CarloFalco/WeatherStation/docs/WeatherStationV2.pdf

### GND

+3V3

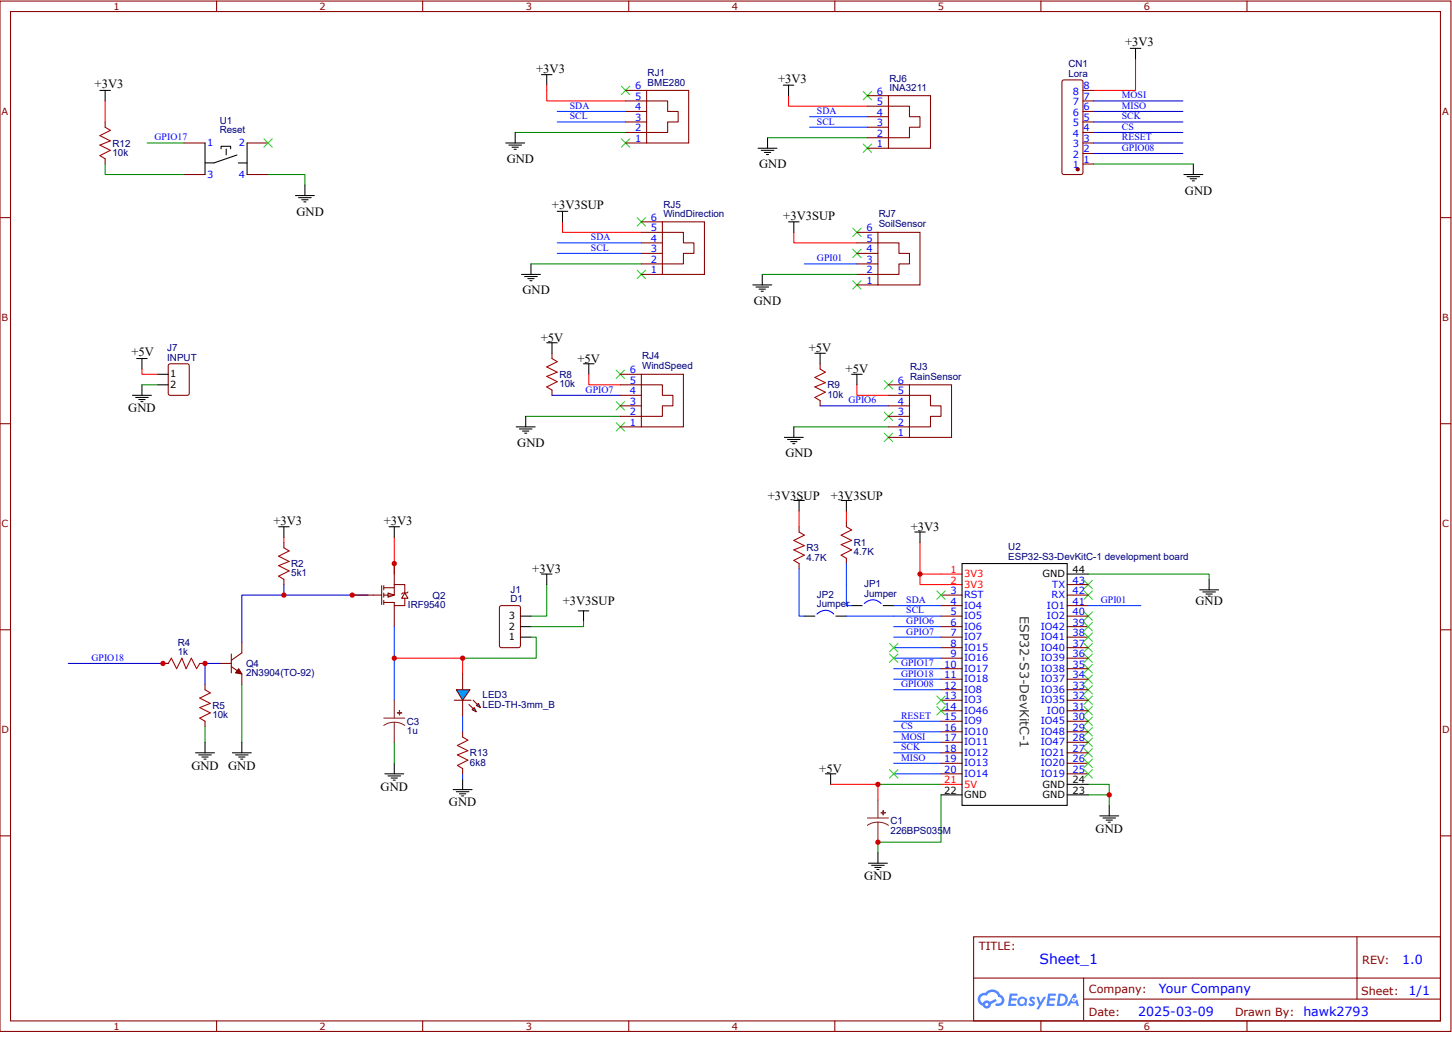
[picture p1: page 1]
