CarloFalco/WeatherStation/docs/WeatherStationV2_PCB.pdf

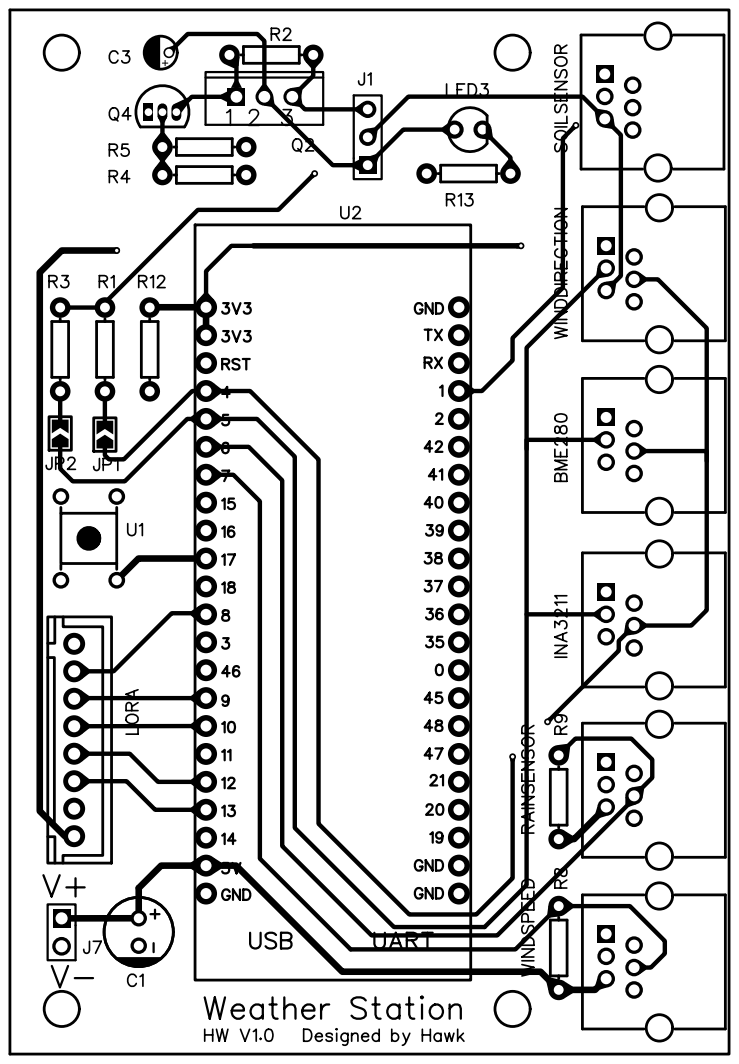
[picture p2: page 1]
