CarloFalco/WeatherStation/include/config.h

/**
 * @file config.h
 * @brief Hardware configuration: GPIO pinout, I2C addresses, board constants.
 *
 * Single source of truth for the wiring of the station. Runtime-tunable
 * parameters (wake interval, station ID, LoRa settings, ...) do NOT belong
 * here: they live in /config.ini on LittleFS (see AppConfig, Increment 1).
 */

#ifndef WEATHERSTATION_CONFIG_H
#define WEATHERSTATION_CONFIG_H

#include <Arduino.h>

// ---------------------------------------------------------------------------
// LoRa SX1276 868 MHz (SPI)
// ---------------------------------------------------------------------------
#define LORA_SCK   GPIO_NUM_12  ///< SPI clock
#define LORA_MISO  GPIO_NUM_13  ///< SPI MISO
#define LORA_MOSI  GPIO_NUM_11  ///< SPI MOSI
#define LORA_CS    GPIO_NUM_10  ///< SPI chip select (NSS)
#define LORA_RST   GPIO_NUM_9   ///< Radio reset
#define LORA_DIO0  GPIO_NUM_8   ///< TX/RX done interrupt

// ---------------------------------------------------------------------------
// I2C bus (BME280, AS5600, INA3221)
// The ESP32-S3 Arduino defaults (SDA=8, SCL=9) clash with LORA_DIO0/LORA_RST,
// so the bus is remapped to GPIO 4/5.
// ---------------------------------------------------------------------------
#define I2C_SDA    GPIO_NUM_4   ///< I2C data
#define I2C_SCL    GPIO_NUM_5   ///< I2C clock

/// BME280 temperature/humidity/pressure sensor I2C address.
/// (Named *_I2C_ADDR because the Adafruit driver already defines
/// BME280_ADDRESS as its 0x77 default.)
#define BME280_I2C_ADDR 0x76
/// AS5600 magnetic encoder (wind direction) I2C address.
#define AS5600_ADDRESS 0x36
/// INA3221 3-channel current monitor (panel/battery/load) I2C address.
#define INA3221_ADDRESS 0x40

// ---------------------------------------------------------------------------
// Pulse sensors (reed switches)
// ---------------------------------------------------------------------------
#define RAIN_GAUGE_PIN GPIO_NUM_6  ///< Tipping-bucket rain gauge (RTC-capable, used for wake-on-rain)
#define ANEMOMETER_PIN GPIO_NUM_7  ///< Cup anemometer reed switch

// ---------------------------------------------------------------------------
// Analog sensors
// ---------------------------------------------------------------------------
/// Capacitive soil moisture probe (analog output).
/// GPIO 1 = ADC1_CH0: ADC1 is mandatory here, ADC2 is unusable while WiFi is
/// on and is reserved on this board anyway.
/// WARNING: the probe must be powered at 3.3 V. Powered at 5 V its output
/// swings up to ~4.2 V and would exceed the ESP32-S3 ADC input rating.
#define SOIL_MOISTURE_PIN GPIO_NUM_1

// ---------------------------------------------------------------------------
// User interface / power control
// ---------------------------------------------------------------------------
/// Factory-reset push button to GND (RTC-capable: also a deep-sleep wake source).
#define FACTORY_RESET_PIN GPIO_NUM_17

/// Sensor rail load-switch control (RTC-capable, state held during deep sleep).
/// Currently only driven to a defined ON level at boot: which devices sit on
/// the switched rail is still an open hardware decision (see
/// docs/power-budget.md), and cutting the rail is only worth it for the
/// AS5600 and the soil probe.
#define SENSOR_POWER_PIN GPIO_NUM_18
/// Logic level that turns the sensor rail ON (depends on the switch topology:
/// direct P-MOSFET gate = LOW, N-MOSFET/inverted driver or boost EN = HIGH).
#define SENSOR_POWER_ON_LEVEL HIGH

// ---------------------------------------------------------------------------
// Misc
// ---------------------------------------------------------------------------
#define STATUS_LED_PIN LED_BUILTIN  ///< On-board status LED (validated on hardware)

/// CPU frequency during the wake window [MHz]. 80 MHz roughly halves the
/// active current vs the default 240 MHz; nothing in the cycle (I2C, SPI,
/// UART, LoRa) needs more.
#define CPU_FREQ_MHZ 80

#endif // WEATHERSTATION_CONFIG_H
