CarloFalco/WeatherStation/include/rtc_state.h

/**
 * @file rtc_state.h
 * @brief State preserved in RTC slow memory across deep-sleep cycles.
 *
 * Variables placed in RTC RAM survive deep sleep but are reset to their
 * initializers on a power-on reset (cold boot). Everything the station
 * must remember between wake-ups without touching flash lives here:
 * flash writes are slow, power-hungry and wear the chip out, RTC RAM
 * is free.
 */

#ifndef WEATHERSTATION_RTC_STATE_H
#define WEATHERSTATION_RTC_STATE_H

#include <Arduino.h>

/**
 * @brief OTA transfer progress, preserved across deep sleep.
 *
 * A full firmware image takes ~20 minutes over LoRa: without this, any
 * interruption would restart the transfer from chunk 0. The station
 * resumes from @ref nextChunk as soon as the base offers the same image
 * again (matching size/crc/chunks).
 */
struct RtcOtaState {
    uint32_t size;        ///< Expected image size [bytes]; 0 = no transfer pending.
    uint32_t crc;         ///< Expected CRC-32 of the whole image.
    uint16_t chunks;      ///< Total number of chunks of the image.
    uint16_t nextChunk;   ///< First chunk still to receive (resume point).
    uint32_t runningCrc;  ///< CRC-32 accumulator over the chunks already stored.
};

/**
 * @brief Persistent station state, kept in RTC RAM between deep sleeps.
 */
struct RtcState {
    uint32_t bootCount;      ///< Wake-up cycles since power-on (1 = cold boot).
    uint16_t msgSeq;         ///< LoRa telemetry sequence counter ("seq" JSON field).
    uint32_t rainPulses;     ///< Tipping-bucket pulses accumulated since the last
                             ///< acknowledged transmission.
    uint64_t nextWakeEpochS; ///< Scheduled time of the next measurement cycle
                             ///< [s, RTC epoch]. The RTC clock keeps running in
                             ///< deep sleep, so after a rain wake-up the station
                             ///< can go back to sleep for the remaining time
                             ///< instead of restarting the full interval.
    RtcOtaState ota;         ///< OTA transfer progress (resume across cycles).
};

/// Global RTC-resident state instance (defined in PowerManager.cpp).
extern RtcState g_rtcState;

#endif // WEATHERSTATION_RTC_STATE_H
