CarloFalco/WeatherStation/src/core/AppConfig.cpp

/**
 * @file AppConfig.cpp
 * @brief Implementation of the INI-based runtime configuration.
 */

#include "AppConfig.h"

#include <LittleFS.h>

bool AppConfig::begin() {
    if (!LittleFS.begin(true /* format on first mount failure */)) {
        log_e("LittleFS mount failed: running on default configuration");
        return false;
    }

    if (load()) {
        log_i("Configuration loaded from %s", kConfigPath);
    } else {
        log_w("%s not found: writing default configuration", kConfigPath);
        save();
    }
    return true;
}

bool AppConfig::load() {
    File file = LittleFS.open(kConfigPath, "r");
    if (!file) {
        return false;
    }

    String section;
    while (file.available()) {
        String line = file.readStringUntil('\n');
        line.trim();

        // Skip blanks and full-line comments.
        if (line.isEmpty() || line[0] == ';' || line[0] == '#') {
            continue;
        }

        // Section header: [name]
        if (line[0] == '[' && line.endsWith("]")) {
            section = line.substring(1, line.length() - 1);
            section.trim();
            section.toLowerCase();
            continue;
        }

        int eq = line.indexOf('=');
        if (eq < 0) {
            log_w("config.ini: ignoring malformed line '%s'", line.c_str());
            continue;
        }

        String key = line.substring(0, eq);
        String value = line.substring(eq + 1);
        key.trim();
        key.toLowerCase();
        value.trim();

        applyKey(section, key, value);
    }
    file.close();
    return true;
}

void AppConfig::applyKey(const String &section, const String &key, const String &value) {
    if (section == "station") {
        if (key == "id") {
            station.id = value;
        } else if (key == "wake_interval_s") {
            long v = value.toInt();
            if (v >= 10) {
                station.wakeIntervalS = (uint32_t)v;
            } else {
                log_w("config.ini: wake_interval_s=%ld too small (<10 s), keeping %lu",
                      v, (unsigned long)station.wakeIntervalS);
            }
        } else if (key == "factory_reset_hold_ms") {
            long v = value.toInt();
            station.factoryResetHoldMs = (uint16_t)constrain(v, 500L, 20000L);
        } else {
            log_w("config.ini: unknown key [station] %s", key.c_str());
        }
        return;
    }

    if (section == "rain") {
        if (key == "mm_per_pulse") {
            float v = value.toFloat();
            if (v > 0.0f && v < 10.0f) {
                rain.mmPerPulse = v;
            } else {
                log_w("config.ini: mm_per_pulse=%s out of range (0..10), keeping %.4f",
                      value.c_str(), rain.mmPerPulse);
            }
        } else {
            log_w("config.ini: unknown key [rain] %s", key.c_str());
        }
        return;
    }

    if (section == "soil") {
        if (key == "dry_raw") {
            long v = value.toInt();
            soil.dryRaw = (uint16_t)constrain(v, 0L, 4095L);
        } else if (key == "wet_raw") {
            long v = value.toInt();
            soil.wetRaw = (uint16_t)constrain(v, 0L, 4095L);
        } else if (key == "samples") {
            long v = value.toInt();
            soil.samples = (uint8_t)constrain(v, 1L, 64L);
        } else {
            log_w("config.ini: unknown key [soil] %s", key.c_str());
        }
        return;
    }

    if (section == "wind") {
        if (key == "mps_per_hz") {
            float v = value.toFloat();
            if (v > 0.0f && v < 10.0f) {
                wind.mpsPerHz = v;
            } else {
                log_w("config.ini: mps_per_hz=%s out of range (0..10), keeping %.3f",
                      value.c_str(), wind.mpsPerHz);
            }
        } else if (key == "sample_window_s") {
            long v = value.toInt();
            wind.sampleWindowS = (uint8_t)constrain(v, 1L, 30L);
        } else if (key == "vane_offset_deg") {
            long v = value.toInt();
            // Normalize any input to 0..359.
            wind.vaneOffsetDeg = (int16_t)(((v % 360) + 360) % 360);
        } else {
            log_w("config.ini: unknown key [wind] %s", key.c_str());
        }
        return;
    }

    if (section == "power") {
        if (key == "shunt_mohm") {
            long v = value.toInt();
            if (v >= 1 && v <= 1000) {
                power.shuntMohm = (uint32_t)v;
            } else {
                log_w("config.ini: shunt_mohm=%ld out of range (1..1000), keeping %lu",
                      v, (unsigned long)power.shuntMohm);
            }
        } else if (key == "rail_settle_ms") {
            long v = value.toInt();
            power.railSettleMs = (uint16_t)constrain(v, 0L, 2000L);
        } else if (key == "rail_off_in_sleep") {
            power.railOffInSleep = (value == "true" || value == "1" || value == "yes");
        } else {
            log_w("config.ini: unknown key [power] %s", key.c_str());
        }
        return;
    }

    if (section == "ota") {
        if (key == "chunk_timeout_ms") {
            long v = value.toInt();
            ota.chunkTimeoutMs = (uint16_t)constrain(v, 200L, 10000L);
        } else if (key == "max_retries") {
            long v = value.toInt();
            ota.maxRetries = (uint8_t)constrain(v, 1L, 50L);
        } else if (key == "session_timeout_s") {
            long v = value.toInt();
            ota.sessionTimeoutS = (uint16_t)constrain(v, 30L, 3600L);
        } else {
            log_w("config.ini: unknown key [ota] %s", key.c_str());
        }
        return;
    }

    if (section == "lora") {
        if (key == "freq_mhz") {
            lora.freqMhz = value.toFloat();
        } else if (key == "bw_khz") {
            lora.bwKhz = value.toFloat();
        } else if (key == "sf") {
            long v = value.toInt();
            lora.sf = (uint8_t)constrain(v, 6L, 12L);
        } else if (key == "cr") {
            long v = value.toInt();
            lora.cr = (uint8_t)constrain(v, 5L, 8L);
        } else if (key == "tx_power_dbm") {
            long v = value.toInt();
            lora.txPowerDbm = (int8_t)constrain(v, 2L, 17L);
        } else if (key == "sync_word") {
            // Accepts both decimal and 0x-prefixed hex.
            lora.syncWord = (uint8_t)strtol(value.c_str(), nullptr, 0);
        } else if (key == "ack_enabled") {
            lora.ackEnabled = (value == "true" || value == "1" || value == "yes");
        } else if (key == "ack_timeout_ms") {
            long v = value.toInt();
            lora.ackTimeoutMs = (uint16_t)constrain(v, 100L, 5000L);
        } else if (key == "tx_retries") {
            long v = value.toInt();
            lora.txRetries = (uint8_t)constrain(v, 0L, 5L);
        } else {
            log_w("config.ini: unknown key [lora] %s", key.c_str());
        }
        return;
    }

    log_w("config.ini: unknown section [%s]", section.c_str());
}

bool AppConfig::save() const {
    File file = LittleFS.open(kConfigPath, "w");
    if (!file) {
        log_e("Cannot open %s for writing", kConfigPath);
        return false;
    }

    file.println("; WeatherStation V2 - runtime configuration");
    file.println("; Edit and re-upload with 'pio run -t uploadfs', or let the");
    file.println("; firmware regenerate this file with defaults if deleted.");
    file.println();
    file.println("[station]");
    file.printf("id = %s\n", station.id.c_str());
    file.printf("wake_interval_s = %lu\n", (unsigned long)station.wakeIntervalS);
    file.printf("factory_reset_hold_ms = %u\n", station.factoryResetHoldMs);
    file.println();
    file.println("[rain]");
    file.printf("mm_per_pulse = %.4f\n", rain.mmPerPulse);
    file.println();
    file.println("[soil]");
    file.printf("dry_raw = %u\n", soil.dryRaw);
    file.printf("wet_raw = %u\n", soil.wetRaw);
    file.printf("samples = %u\n", soil.samples);
    file.println();
    file.println("[wind]");
    file.printf("mps_per_hz = %.3f\n", wind.mpsPerHz);
    file.printf("sample_window_s = %u\n", wind.sampleWindowS);
    file.printf("vane_offset_deg = %d\n", wind.vaneOffsetDeg);
    file.println();
    file.println("[power]");
    file.printf("shunt_mohm = %lu\n", (unsigned long)power.shuntMohm);
    file.printf("rail_settle_ms = %u\n", power.railSettleMs);
    file.printf("rail_off_in_sleep = %s\n", power.railOffInSleep ? "true" : "false");
    file.println();
    file.println("[lora]");
    file.printf("freq_mhz = %.1f\n", lora.freqMhz);
    file.printf("bw_khz = %.1f\n", lora.bwKhz);
    file.printf("sf = %u\n", lora.sf);
    file.printf("cr = %u\n", lora.cr);
    file.printf("tx_power_dbm = %d\n", lora.txPowerDbm);
    file.printf("sync_word = 0x%02X\n", lora.syncWord);
    file.printf("ack_enabled = %s\n", lora.ackEnabled ? "true" : "false");
    file.printf("ack_timeout_ms = %u\n", lora.ackTimeoutMs);
    file.printf("tx_retries = %u\n", lora.txRetries);
    file.println();
    file.println("[ota]");
    file.printf("chunk_timeout_ms = %u\n", ota.chunkTimeoutMs);
    file.printf("max_retries = %u\n", ota.maxRetries);
    file.printf("session_timeout_s = %u\n", ota.sessionTimeoutS);

    file.close();
    return true;
}

bool AppConfig::factoryReset() {
    LittleFS.remove(kConfigPath);

    // Assigning a fresh instance restores every compiled-in default in one
    // go: no risk of forgetting a field when new sections are added.
    station = StationConfig{};
    rain = RainConfig{};
    soil = SoilConfig{};
    wind = WindConfig{};
    power = PowerConfig{};
    lora = LoraConfig{};
    ota = OtaConfig{};

    bool ok = save();
    log_w("Factory reset: configuration restored to defaults (%s)",
          ok ? "saved" : "SAVE FAILED");
    return ok;
}

void AppConfig::printTo(Stream &out) const {
    out.println("Active configuration:");
    out.printf("  [station] id              = %s\n", station.id.c_str());
    out.printf("  [station] wake_interval_s = %lu\n", (unsigned long)station.wakeIntervalS);
    out.printf("  [rain]    mm_per_pulse    = %.4f\n", rain.mmPerPulse);
    out.printf("  [soil]    dry_raw/wet_raw = %u / %u\n", soil.dryRaw, soil.wetRaw);
    out.printf("  [wind]    mps_per_hz      = %.3f\n", wind.mpsPerHz);
    out.printf("  [wind]    sample_window_s = %u\n", wind.sampleWindowS);
    out.printf("  [wind]    vane_offset_deg = %d\n", wind.vaneOffsetDeg);
    out.printf("  [power]   shunt_mohm      = %lu\n", (unsigned long)power.shuntMohm);
    out.printf("  [power]   rail_off_in_sleep = %s\n", power.railOffInSleep ? "true" : "false");
    out.printf("  [lora]    freq_mhz        = %.1f\n", lora.freqMhz);
    out.printf("  [lora]    bw_khz          = %.1f\n", lora.bwKhz);
    out.printf("  [lora]    sf              = %u\n", lora.sf);
    out.printf("  [lora]    cr              = 4/%u\n", lora.cr);
    out.printf("  [lora]    tx_power_dbm    = %d\n", lora.txPowerDbm);
    out.printf("  [lora]    sync_word       = 0x%02X\n", lora.syncWord);
    out.printf("  [lora]    ack_enabled     = %s\n", lora.ackEnabled ? "true" : "false");
    out.printf("  [lora]    ack_timeout_ms  = %u\n", lora.ackTimeoutMs);
    out.printf("  [lora]    tx_retries      = %u\n", lora.txRetries);
    out.printf("  [ota]     chunk_timeout_ms= %u\n", ota.chunkTimeoutMs);
    out.printf("  [ota]     max_retries     = %u\n", ota.maxRetries);
    out.printf("  [ota]     session_timeout_s = %u\n", ota.sessionTimeoutS);
}
