CarloFalco/WeatherStation/(commit log)

2022-10-03 inizio a lavoraci - ho inserito la foto con il pinout - ho creato al cartella .json - ho creato il main
2025-01-15 Diviso ESP32 in due file .h e .cpp, e separate le funzioni di lettura dei messaggi MQTT
2025-01-17 sistemati i print, messaggio relativo allo stato del aggiornamento, aggiunta la funzione per la gestione del led.
2025-06-02 Add all Sensor to main program
    [configuration.h]
2025-06-02 Test Software update via GIT
    [configuration.h]
2025-06-02 Start Sensor integration INA3221
    [configuration.h]
2025-06-03 Fix print, and add BM280
    [configuration.h]
2025-06-04 Fix print on MQTT function
    [main.cpp]
2025-06-04 Integration json document
    [configuration.h]
2025-06-04 Add other sensor, and expand the json data
    [configuration.h]
2025-06-06 New build, for test OTA
    [configuration.h]
2025-06-10 major changes, not tested
    [configuration.h]
2025-06-14 Added libraries for the rest of the sensors, split MQTT data sending into multiple messages, optimized processes
    [configuration.h]
2025-06-15 main: Add all sensor function
    [configuration.h]
2025-06-15 MICS6814: bug on misc sensor.
2025-06-15 Add rain sensor, new update avaiable, and new script
    [configuration.h]
2025-06-15 minor fix
    [configuration.h]
2026-04-13 First commit on new revision
    [configuration.h]
2026-04-14 Commit first release
    [partitions.csv]
2026-04-14 feat: Increment 0 – project scaffold & provisioning wizard - PlatformIO project with custom 4MB partition table (OTA + LittleFS) - AppConfig singleton: INI parser/serialiser on LittleFS - Provisionin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
2026-04-14 feat: post-build script + PDF documentation generator - post_build.py: reads FW_VERSION from version.h, writes version.txt, copies WeatherStation_vX.Y.Z.bin to project root, then invokes generate_doc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
2026-04-14 feat: bugfix compilation Provisioning: remove const from formParam() to fix build error caused by non-const WebServer::hasArg()/arg()
    [version.h]
2026-07-08 ## [0.2.0] – 2025-04-14
    Added:
    - PowerManager
    - WiFiManager
    - TimeManager
2026-07-08 chore: fresh start for WeatherStation V2
    Remove v0.2.0 codebase and start over from requirements.MD.
    The V2 rewrite targets a battery-powered LoRa station (no WiFi on the
    node): sensors -> JSON -> LoRa -> gateway, with OTA over LoRa planned.
    Old history and tags (v0.1.x) are kept for reference; new firmware
    versions start at v2.0.0.
    [partitions.csv]
2026-07-08 feat: Increment 0 - project scaffold and architecture
    - PlatformIO project for ESP32-S3 (Arduino framework, LittleFS,
    4MB OTA-ready partition table with dual app slots)
    - include/config.h: full pinout (SX1276 LoRa, I2C sensors, reed switches)
    - include/version.h: SemVer firmware version, V2 series starts at 2.0.0
    - src/main.cpp: boot banner with fw version and wake-up cause, LED heartbeat
    - docs/architecture.md: module layout, ISensor/ITelemetryLink interfaces,
    power strategy, increment roadmap
    - GitHub Actions release workflow (build + .bin asset on v*.*.* tag push)
    - README, CHANGELOG, .gitignore, docs/progress/progress_step_00.md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
    [partitions.csv]
2026-07-08 fix: apply Increment 0 hardware validation feedback
    - STATUS_LED_PIN = LED_BUILTIN (validated on the user board)
    - I2C bus confirmed on SDA=GPIO4 / SCL=GPIO5
    - Module identified as ESP32-S3-WROOM-1-N16R8: flash size raised to 16MB
    with 4MB dual OTA slots and ~7.9MB LittleFS; PSRAM kept disabled to
    reduce power consumption
    [partitions.csv]
2026-07-08 feat: Increment 1 - AppConfig runtime configuration + LoRa protocol draft
    - src/core/AppConfig: minimal INI parser/serializer on LittleFS for
    /config.ini with [station] (id, wake_interval_s) and [lora] (freq, bw,
    sf, cr, tx_power, sync_word) sections; defaults in code and automatic
    file regeneration when missing, range validation with warnings
    - data/config.ini: default filesystem image content
    - docs/lora-protocol.md: draft radio parameters (868.1 MHz, BW125, SF7,
    CR 4/5, sync 0x12) and telemetry JSON reference with field/unit table,
    for the debug receiver implementation
    - main.cpp: load and print active configuration at boot
    - version 2.1.0, changelog, progress_step_01.md
    Co-Aut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
    [AppConfig.cpp, AppConfig.h, config.ini, main.cpp, version.h]
2026-07-08 feat: Increment 2 - PowerManager, deep sleep and RTC-resident state
    - src/core/PowerManager: wake-up cause classification, timer-armed deep
    sleep on wake_interval_s, hook point prepared for the rain-gauge EXT
    wake-up (Increment 4)
    - include/rtc_state.h: RtcState in RTC slow memory (bootCount, msgSeq,
    rainPulses) surviving deep sleep, hardware-zeroed on power-on
    - main.cpp restructured into the real duty cycle: wake -> banner with
    boot count -> config -> measurement window placeholder -> deep sleep;
    loop() is never reached
    - version 2.2.0, changelog, progress_step_02.md
2026-07-08 feat: Increment 3 - ISensor interface, SensorManager and BME280
    - src/sensors/ISensor.h: extension point of the firmware; each sensor
    writes its own fields into the telemetry JSON (absent fields = sensor
    unavailable, per docs/lora-protocol.md)
    - src/sensors/SensorManager: fixed-capacity registry (no heap); sensors
    failing begin() are marked unhealthy and skipped without blocking the
    cycle or the other sensors
    - src/sensors/Bme280Sensor: first real sensor (I2C 0x76), Bosch weather
    monitoring profile (forced mode, 1x oversampling, IIR off) producing
    t [degC], rh [%], p [hPa] rounded to one decimal
    - main.cpp: real measurement window - Wire init, sensor registration,
    telemetry JSO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
    [Bme280Sensor.cpp, Bme280Sensor.h, ISensor.h, SensorManager.cpp, SensorManager.h, config.h, main.cpp]
2026-07-09 feat: Increment 4 - rain gauge with RTC accumulation and wake-on-rain
    - src/sensors/RainGauge: tipping-bucket pulse counting on GPIO 19
    (input pull-up, falling edge) with 150 ms software debounce; pulses
    accumulate in RTC RAM so no rain is lost across deep-sleep cycles;
    produces the rain [mm] JSON field, accumulator reset after each send
    - PowerManager::deepSleep: EXT0 wake-up armed on the rain-gauge pin with
    the RTC-domain pull-up enabled (the digital one powers down in sleep)
    - main.cpp quick path: an EXT0 wake-up counts the tip and goes straight
    back to sleep for the remaining time (RtcState::nextWakeEpochS + RTC
    clock), skipping serial wait, sensors and radio - a rain event c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
    [AppConfig.cpp, AppConfig.h, PowerManager.cpp, RainGauge.cpp, RainGauge.h, config.ini, main.cpp, rtc_state.h]
2026-07-09 feat: Increment 5 - anemometer and AS5600 wind vane
    - src/sensors/Anemometer: pulse counting on GPIO 20 (pull-up, falling
    edge, 5 ms debounce) sampled in 1-second bins over a configurable
    window; produces ws (average) and wg (gust = busiest bin) in m/s
    - src/sensors/WindVane: AS5600 driven directly over Wire (raw angle
    register, 12 bit) with magnet-presence check at begin(); produces
    wd [deg, 0-359, 0 = North]; raw angle logged at debug level for
    field calibration of the mounting offset
    - config.ini [wind] section: mps_per_hz (default 0.667, i.e. the cup
    anemometer convention of 1 Hz = 2.4 km/h, to be replaced with the real
    datasheet value), sample_window_s, vane_offset_deg (no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
    [Anemometer.cpp, Anemometer.h, AppConfig.cpp, AppConfig.h, WindVane.cpp, WindVane.h, config.ini, main.cpp]
2026-07-09 feat: Increment 6 - INA3221 power monitor with SoC estimation
    Reworked from the user-provided INA3221 library base (Beast Devices, MIT,
    attribution kept) into project-coherent modules:
    - src/sensors/Ina3221Driver: minimal register-level driver; single-shot
    conversions (chip self powers down between cycles, ~0.35 mA saved vs
    continuous mode) and SIGNED shunt readings (13-bit two complement) that
    make the old getAll() battery-sign workarounds unnecessary
    - src/sensors/PowerMonitor: ISensor for CH1 = solar panel, CH2 = battery,
    CH3 = load; produces vbat [V], soc [%], ibat/ipan/iload [mA] with
    ibat positive = charging; battery rail below 100 mV discards readings
    instead of faking a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
    [AppConfig.cpp, AppConfig.h, Ina3221Driver.cpp, Ina3221Driver.h, PowerMonitor.cpp, PowerMonitor.h, config.ini, main.cpp]
2026-07-09 feat: compile-time debug dumps of all sensor readings
    Debug messages via the framework log_d macros, gated by CORE_DEBUG_LEVEL
    at compile time (chosen over a custom #define DEBUG: same zero-cost
    stripping in production, plus timestamps and source context for free):
    - Bme280Sensor: T / RH / P
    - Anemometer: pulse count, average (m/s and km/h) and gust
    - WindVane: raw angle, direction with 16-point compass rose
    - RainGauge: pulse count and accumulated mm
    - PowerMonitor: voltage and current of all three channels (panel,
    battery with SoC, load); panel/load voltages read inside the macro so
    they disappear from production builds too
    platformio.ini: CORE_DEBUG_LEVEL raised to 4 (debug) for dev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
2026-07-09 fix: INA3221 channel mapping verified on hardware
    The old prototype comment had the channels wrong: the actual board
    wiring is CH1 = load, CH2 = battery, CH3 = solar panel. This explains
    the swapped panel/load voltages and the panel current stuck at 0 seen
    during the Increment 6 validation (that channel was really the load,
    which draws ~nothing through its shunt while the board is USB-powered).
    [PowerMonitor.h]
2026-07-09 fix: INA3221 current readings were 1000x too small
    uV / mOhm already yields mA (1e-6 / 1e-3 = 1e-3): the extra /1000 was a
    leftover from the old prototype code, whose getCurrent() returned amps.
    Battery/panel currents observed during validation (-0.8 mA instead of
    hundreds of mA, panel rounding to 0) match the misscaling exactly.
    [Ina3221Driver.cpp]
2026-07-09 fix: INA3221 shunt resistance is 100 mOhm on the actual board
    Verified against a reference current during Increment 6 validation:
    610 mA of battery charge current produced ~61 mV across the shunt,
    i.e. 100 mOhm (the 10 mOhm value inherited from the old prototype code
    made all currents read 10x too large). Default updated in code and
    config.ini; the value stays runtime-tunable via [power] shunt_mohm.
    [AppConfig.h, Ina3221Driver.h, config.ini]
2026-07-09 feat: Increment 7 - LoRa telemetry transmission over SX1276
    - src/comm/ITelemetryLink.h: transport abstraction (begin/send/sleep) so
    the future direct-MQTT variant plugs in without touching main.cpp
    - src/comm/LoRaLink: SX1276 via RadioLib on the dedicated SPI bus, radio
    parameters from config.ini [lora] (freq/BW/SF/CR/sync/power), CRC on,
    preamble 8; blocking fire-and-forget transmit with estimated
    time-on-air in the debug log; sleep() puts the SX1276 in sleep mode
    (~0.2 uA) before MCU deep sleep - otherwise it would idle in standby
    at ~1.6 mA forever
    - main.cpp: telemetry JSON now transmitted each cycle, TX outcome on
    serial; radio always put to sleep before the MCU
    - deps: R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
2026-07-09 fix: DebugLora receiver aligned to the station radio parameters
    The debug receiver sketch (second ESP32-S3 + SX1276) was listening on
    868.0 MHz while the station transmits on 868.1: with BW 125 kHz that
    offset is enough to lose nearly every packet, matching the observed
    one-packet-then-silence behaviour. Also: explicit sync word 0x12,
    CRC enabled to match the station TX, JSON document 256 -> 512 B
    (~160 B payload was borderline for ArduinoJson v6), TX power 17 -> 14
    dBm (EU868 ERP limit), raw packet dump before parsing for debugging.
    [DebugLora.ino]
2026-07-14 feat: Increment 8 - ACK protocol and reliable delivery
    - ITelemetryLink/LoRaLink: receive(payload, timeout) - RadioLib
    RX-single polled until the deadline; CRC-failed packets are logged
    and ignored without closing the window
    - main.cpp: TX -> RX window (ack_timeout_ms) -> ACK matching on
    type/id/seq, unrelated packets ignored; missing ACK triggers
    retransmission of the same message (same seq) up to tx_retries times
    - RainGauge: accumulator consumed by subtracting the reported snapshot
    (under interrupt lock) and only on confirmed delivery - no bucket tip
    lost to dropped packets or during the ACK window
    - config.ini [lora]: ack_enabled (true), ack_timeout_ms (600),
    tx_retries (1)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
    [AppConfig.cpp, AppConfig.h, DebugLora.ino, RainGauge.cpp, RainGauge.h]
2026-07-14 chore: adopt HIGH-priority items from the ESP32 + Claude Code workflow guide
    Implements the ALTA-priority sections of workflow-esp32-claude-code.md
    (CLAUDE.md and docs/pinout.md were drafted by the user; protocols were
    already covered by docs/lora-protocol.md):
    - platformio.ini: [env:native] (unity, host) + time monitor filter
    - src/logic/: first pure-logic extraction - logic::vbatToSoc moved out of
    PowerMonitor (no Arduino headers); 6 native unit tests in
    test/test_battery_soc, all passing on the host in seconds
    - scripts/check.sh: single quality gate (native tests + station build,
    --fast to skip tests); locates pio outside PATH on Windows
    - docs/troubleshooting.md: append-only, seed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
    [PowerMonitor.cpp, PowerMonitor.h]
2026-07-14 feat: Doxygen documentation pipeline + reed switches moved to GPIO 6/7
    Doxygen (workflow guide item 5.5):
    - docs/Doxyfile: minimal config, firmware version injected from
    include/version.h via FW_VERSION env var; inputs = src, include,
    README, CHANGELOG, architecture and LoRa protocol docs; HTML only,
    no graphviz required; IRAM_ATTR/RTC_DATA_ATTR predefined away
    - scripts/gen_docs.sh: one-command local generation into docs/html/
    (verified locally with doxygen 1.16.1, no warnings)
    - .github/workflows/docs.yml: regenerates and publishes to GitHub Pages
    (gh-pages branch) on every push to main - requires one-time repo
    setting: Settings -> Pages -> deploy from branch gh-pages
    - CLAUDE.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
2026-07-14 feat: Increment 9 - power optimization and autonomy estimate
    - AS5600 forced into LPM3 at begin() (~1.5 mA vs ~6.5 mA): the vane has
    no enable pin and stays powered through deep sleep, making it the
    dominant item of the whole power budget (a 3 Ah battery would last
    ~18 days with the default mode). CONF register is volatile, so the
    mode is re-applied on every wake-up (no-op when already set)
    - CPU at 80 MHz during the wake window (CPU_FREQ_MHZ in config.h):
    roughly half the active current, nothing in the cycle needs 240 MHz
    - new station-release env (CORE_DEBUG_LEVEL=2): log_d/log_i stripped
    from the binary and the 2 s USB enumeration wait skipped; CI releases
    now ship the produ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
    [WindVane.cpp, WindVane.h, config.h, main.cpp, version.h]
2026-07-14 feat: auto-regenerate Doxygen docs after each firmware build
    scripts/post_build_docs.py wired as a PlatformIO post extra_script on the
    station (dev) env: after every successful build it extracts FW_VERSION
    from include/version.h and runs doxygen on docs/Doxyfile, updating
    docs/html/. Attached to the dev env only so check.sh (which builds both
    envs) does not generate the docs twice; runs only on actual rebuilds
    (up-to-date builds skip post actions). Missing or failing doxygen prints
    a warning and never breaks the firmware build.
2026-07-17 feat: OTA stage 1 - chunked file transfer over LoRa (3.0.0-alpha.1)
    Opens the 3.0 series (OTA over LoRa). Agreed staging: stage 1 = protocol
    + test-file transfer + ACK/retransmission + CRC; stage 2 = OTA partition
    write, reboot, rollback; stage 3 = firmware signature; MQTT dashboard
    belongs to the future gateway.
    - docs/lora-protocol.md v1.1: OTA offer piggybacked in the telemetry ACK
    (ota{size,crc,chunks,ver}); pull model - the station requests every
    chunk with ota_req, so ordering and retransmission are implicit;
    binary chunks (0xA5 + u16 LE index + up to 180 bytes, no base64 waste);
    final ota_done report; timing and stage roadmap
    - src/logic/crc32: IEEE CRC-32, incremental API fo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
    [DebugLora.ino, OtaReceiver.cpp, OtaReceiver.h, main.cpp]
2026-07-23 feat: DebugOta.ino - GitHub-to-LoRa OTA gateway prototype
    Test gateway (ESP32-S3 + WiFi + SX1276): polls GitHub Releases for the
    latest firmware, downloads the .bin to LittleFS while computing its
    CRC-32, and transfers it to the station over LoRa using the stage 1 OTA
    protocol (offer piggybacked in the telemetry ACK, pull-model chunk
    serving from the file, ota_done verdict). Compares the GitHub tag against
    the station fw field reported in telemetry to decide whether an update
    is needed. Serial commands: u (check GitHub now), f (force offer even if
    versions match - needed to re-test since stage 1 does not flash yet, so
    the station fw string does not change), i (status). Basis for the future
    d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
2026-07-23 fix: OTA transfer of a real firmware image (3.0.0-alpha.2)
    First transfer of an actual 425 kB image (2365 chunks) failed every time.
    Three distinct bugs, found from the station and gateway logs:
    1. Session timeout. kSessionTimeoutMs was 120 s, sized for the 4 kB test
    file. A real image needs ~20 min at the measured 0.5 s/chunk, so the
    transfer always died around chunk 240 - the logs show 120.3 s, exactly
    the cap. Now session_timeout_s in config.ini, default 1800 s.
    2. Receive gaps. receiveRaw() used RadioLib blocking receive(), which
    listens in ~102 ms RX-single windows and stops in between: a chunk
    whose preamble landed in a gap was lost, which is what produced the
    repea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
    [AppConfig.cpp, AppConfig.h, DebugLora.ino, DebugOta.ino, OtaReceiver.cpp, OtaReceiver.h, main.cpp]
2026-08-02 feat: soil moisture probe and factory reset button (3.0.0-alpha.3)
    Pinout verified against the ESP32-S3-N16R8 constraints: GPIO 1 (ADC1_CH0,
    mandatory since ADC2 is unusable with WiFi), 17 and 18 are all RTC-capable
    and free; none is a strapping, PSRAM, USB or flash pin. Only electrical
    caveat: the capacitive probe must run at 3.3 V, at 5 V its output reaches
    ~4.2 V and exceeds the ADC input rating.
    - logic::soilRawToPercent (src/logic/): inverse conversion typical of
    capacitive probes, with clamping and rejection of an inconsistent
    calibration; 7 native unit tests
    - SoilMoistureSensor: averaged ADC reads, 12 dB attenuation, plausibility
    window so a floating input reports nothing inst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
2026-08-02 feat: switch off the sensor rail during deep sleep (3.0.0-alpha.4)
    Hardware topology confirmed: GPIO 18 -> 10k pull-down + NPN -> IRF9540
    high-side switch on a dedicated 3.3 V rail feeding AS5600 and the soil
    probe, while BME280, INA3221 and SX1276 stay always powered. That is
    exactly the split the power budget called for, so the rail is now really
    cut before deep sleep instead of just being driven to a defined level.
    - main.cpp: before sleeping, Wire.end() and SDA/SCL back to plain inputs,
    then the rail off. The AS5600 shares the bus with always-on devices, so
    leaving the pull-ups driven would feed it through its ESD diodes and
    keep it partially alive
    - PowerManager::waitSensorRailSe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
2026-10-21 fix: guard deep-sleep wake inputs stuck low; board v1.0 schematic review
    First printed board (schematic and PCB added to docs/ as PDF). The pinout
    matches include/config.h block by block, so no firmware pin changes.
    Firmware (3.0.0-alpha.5): EXT1 ANY_LOW is level-triggered, so a wake input
    still low when the chip goes to sleep wakes it again at once. Before
    sleeping, each wake input is now checked: if low, wait up to 300 ms for a
    stable release, otherwise leave it out of the wake mask for that cycle
    (the timer still wakes the station). This covers the rain gauge reed still
    closed at the end of a quick-path wake (the same tip would be counted
    twice) and an input stuck low for good - bucket r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
2026-10-21 docs: real rain/wind sensors on board v1.0 and IRF9540 alternatives
    - Rain gauge is an A3144 Hall sensor (5 V supply, open-collector output):
    moving R9 to +3V3 is enough, the pull-up alone sets the high level, so
    no divider or level shifter is needed. Flagged its ~4.4 mA quiescent
    current (always on as the wake source): ~105 mAh/day, autonomy without
    sun from ~315 to ~26 days. Alternatives: reed switch (0 uA) or a
    low-power sampled Hall sensor with a fast enough sampling period.
    - Anemometer is a WH-SP-WS01 passive reed: R8 to +3V3SUP as suggested.
    - Switched rail: logic-level P-MOSFET drop-ins (AO3401A, IRLML6402,
    Si2301CDS, DMG3415U, note the pin order differs from TO-220) and,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
